oubijiyu/Environmental_Data_Records/(notices)

Notices in the files:
System/usart/usart.c:
Copyright(C) ¹ãÖÝÊÐÐÇÒíµç×Ó¿Æ¼¼ÓÐÏÞ¹«Ë¾ 2009-2019
All rights reserved
